tobyrobb/Ardev-Version-2/ARDEV2_top.jpg

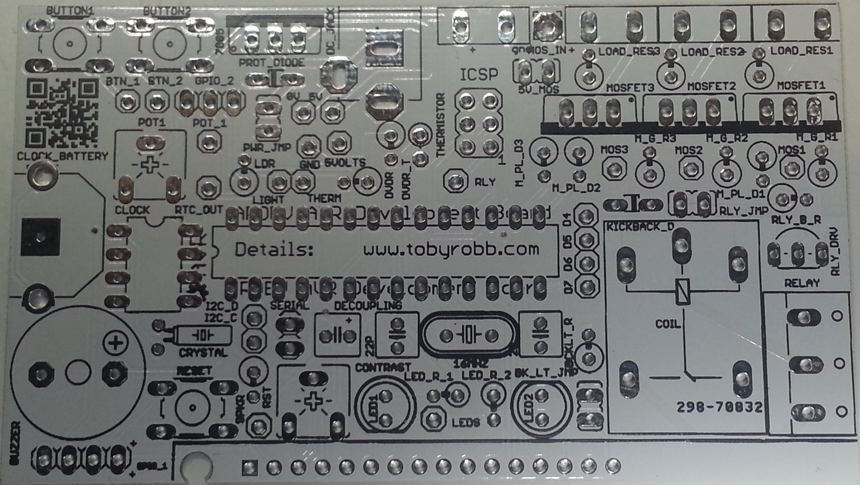
ARDEV2_top.jpg
