tobyrobb/Ardev-Version-2/PCB_LAYOUT.jpg

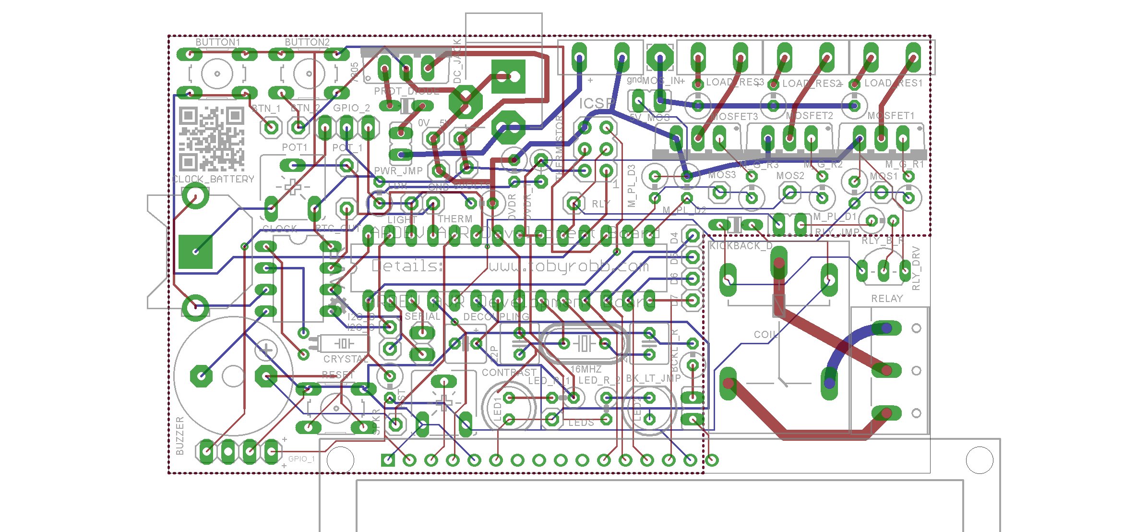
PCB_LAYOUT.jpg
