tobyrobb/Ardev-Version-2/README.md

Ardev-Version-2
===============

A code repository for the ARDEV version 2 Arduino IDE based development board

Try here for information about the board.

http://tobyrobb.com/wordpress/?p=747
