tobyrobb/Ardev-Version-2/ARDEV2_bottom.jpg

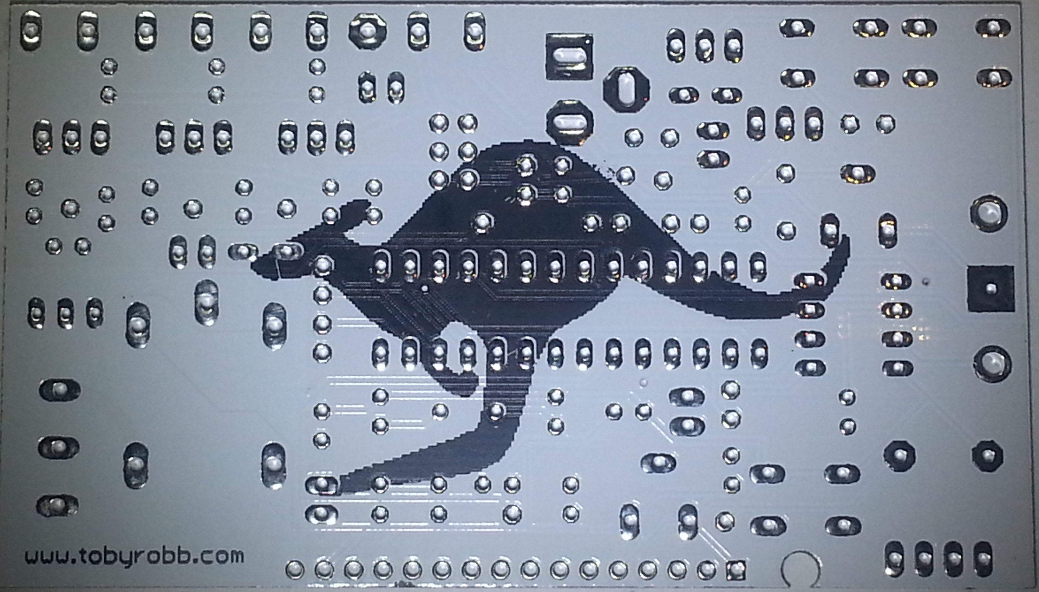
ARDEV2_bottom.jpg
