tobyrobb/Ardev-Version-2/ARDEV2_SCHEMATIC.jpg

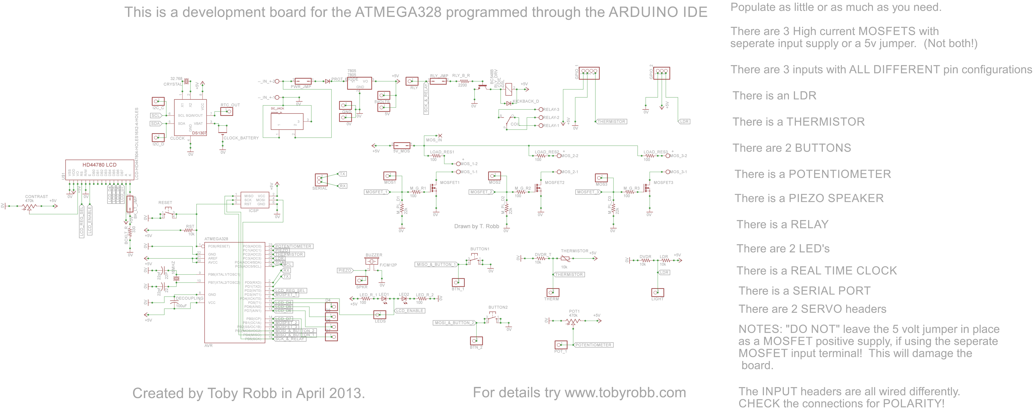
ARDEV2_SCHEMATIC.jpg
