tobyrobb/Ardev-Version-2/Populated.jpg

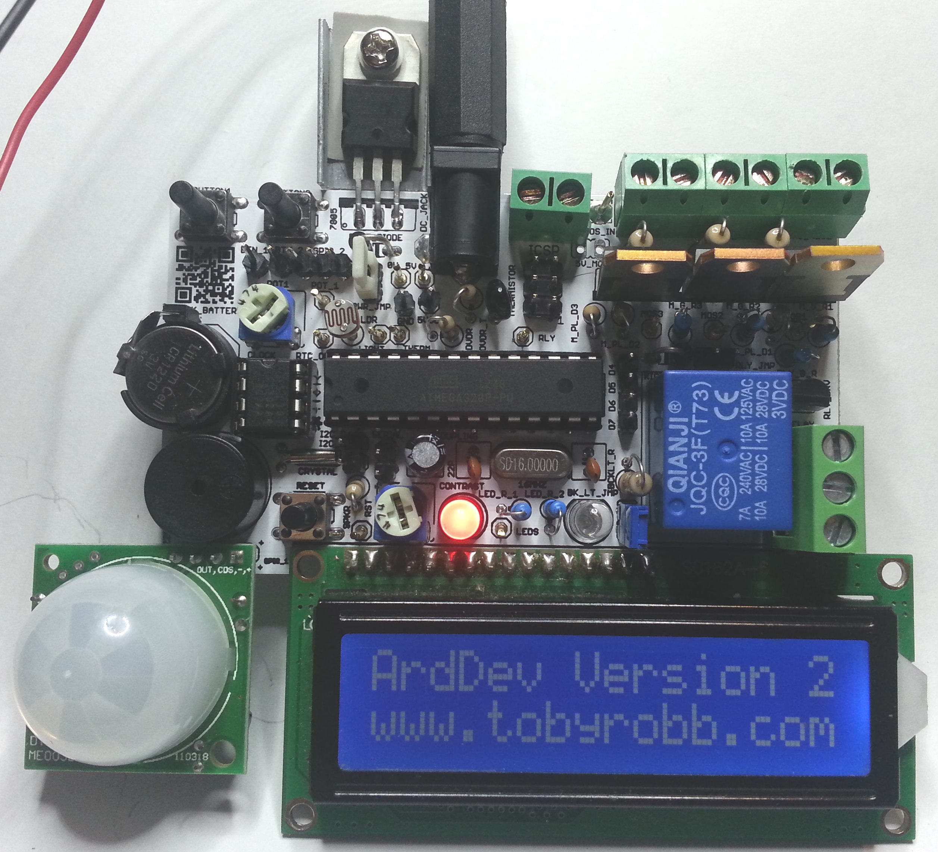
Populated.jpg
