tobyrobb/Ardev-Version-2/Populated_close_up.jpg

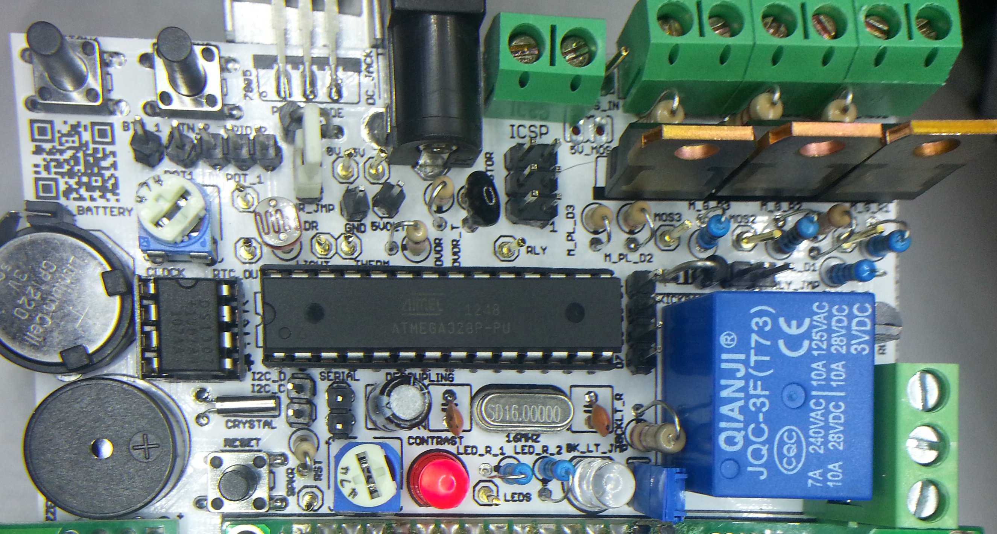
Populated_close_up.jpg
