tobyrobb/Ardev-Version-2/Ardev version 3.brd

## EAGLE design Ardev version 3.brd (2014-05-05)

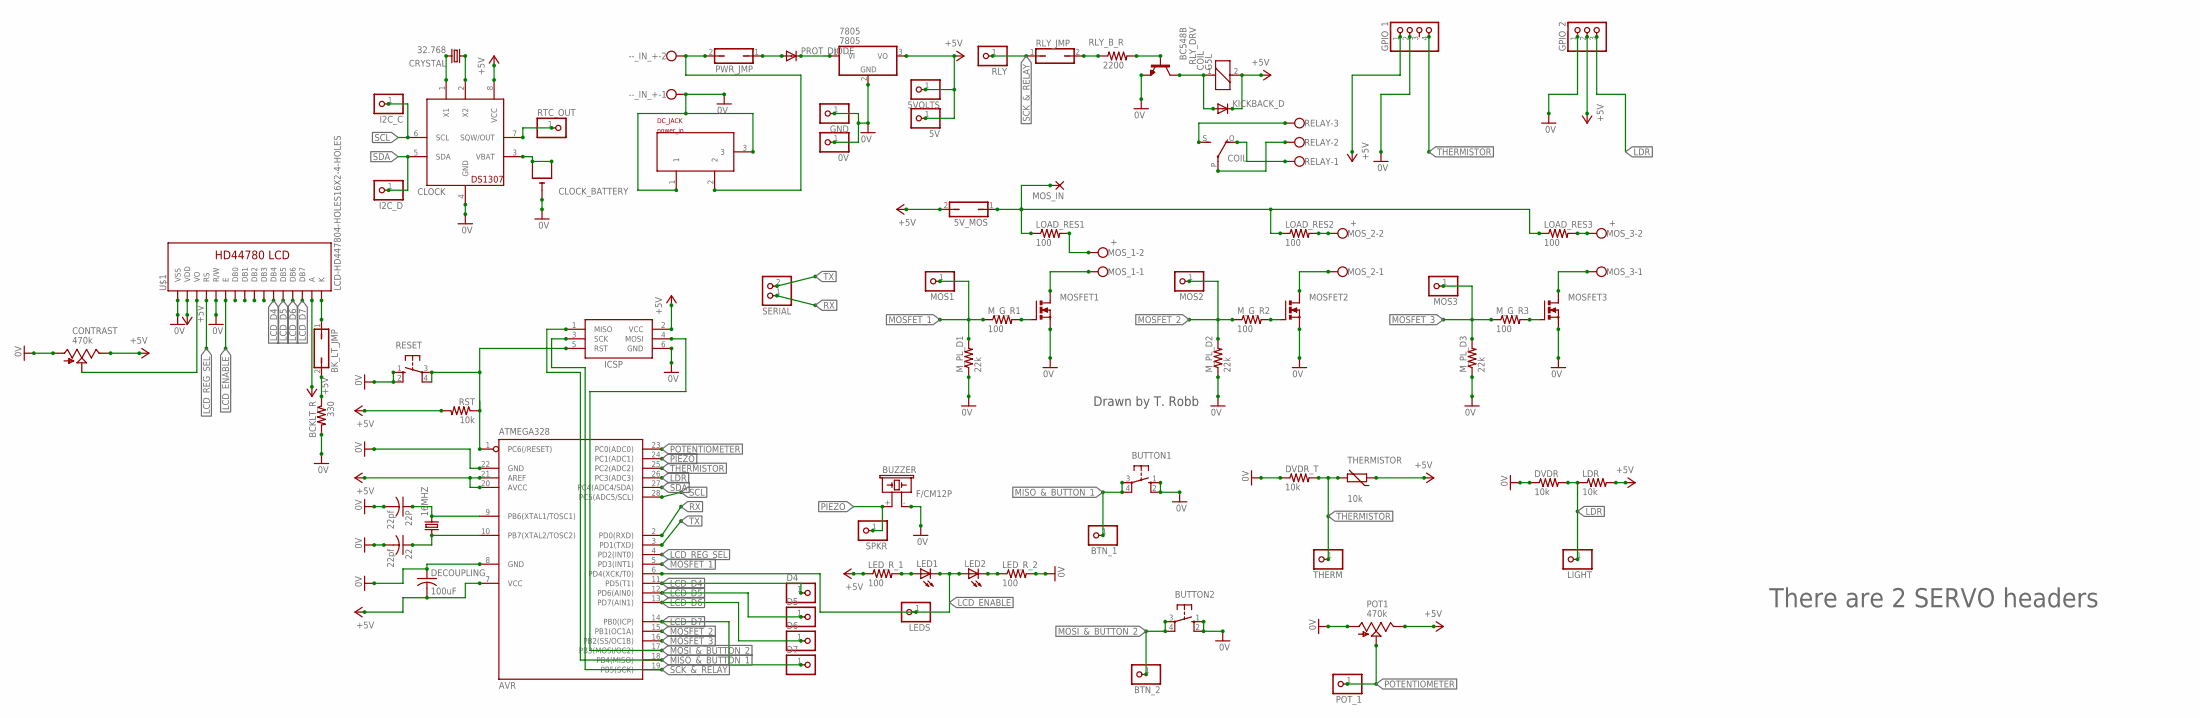
[picture p7: schematic Ardev version 3.sch]

Parts:
0V, 5V, 5VOLTS: PINHD-1X1; 1X01
5V_MOS: JP1Q; JP1
16MHZ: CRYSTALHC49U-V; HC49U-V
22, 22P: 22pf; C025-050X050
7805: 7805; TO220V
--_IN_+: W237-102
AVR: ATMEGA328; DIL28-3
BCKLT_R: 330; 0309V
BK_LT_JMP: JP1Q; JP1
BTN_1, BTN_2: PINHD-1X1; 1X01
BUTTON1, BUTTON2: 10-XX; B3F-10XX
BUZZER: F/CM12P
CLOCK: DS1307; DIL08
CLOCK_BATTERY: CR1220THM; CR1220-THM
COIL: G5L; G5LE
CONTRAST: 470k; CA6V
CRYSTAL: 32.768; TC26H
D4, D5, D6, D7: PINHD-1X1; 1X01
DC_JACK: power_in; SMARTPRJ_POWERSUPPLY_DC-21MM
DECOUPLING: 100uF; C025-050X050
DVDR: 10k; 0309V
DVDR_T: 10k; 0309V
GND: PINHD-1X1; 1X01
GPIO_1: PINHD-1X4; 1X04
GPIO_2: PINHD-1X3; 1X03
I2C_C, I2C_D: PINHD-1X1; 1X01
ICSP: AVRISP-6; AVRISP
KICKBACK_D: DIODE-D-7.5; D-7.5
LDR: 10k; 0309V
LED1, LED2: LED5MM
LEDS: PINHD-1X1; 1X01
LED_R_1, LED_R_2: 100; 0207/2V
LIGHT: PINHD-1X1; 1X01
LOAD_RES1, LOAD_RES2, LOAD_RES3: 100; 0309V
MOS1, MOS2, MOS3: PINHD-1X1; 1X01
MOSFET1, MOSFET2, MOSFET3: IRF512; TO220BV
MOS_1, MOS_2, MOS_3: +; W237-102
MOS_IN: 3,17/1,3
M_G_R1, M_G_R2, M_G_R3: 100; 0309V
M_PL_D1, M_PL_D2, M_PL_D3: 22k; 0309V
POT1: 470k; CA6V
POT_1: PINHD-1X1; 1X01
PROT_DIODE: DIODE-D-7.5; D-7.5
PWR_JMP: JP1Q; JP1
RELAY: W237-103
RESET: 10-XX; B3F-10XX
RLY: PINHD-1X1; 1X01
RLY_B_R: 2200; 0309V
RLY_DRV: BC548B; TO92-EBC
RLY_JMP: JP1Q; JP1
RST: 10k; 0309V
RTC_OUT: PINHD-1X1; 1X01
SERIAL: PINHD-1X2; 1X02
SPKR: PINHD-1X1; 1X01
THERM: PINHD-1X1; 1X01
THERMISTOR: 10k; RS-2,5
U$1: LCD-HD447804-HOLES16X2-4-HOLES; LCD-16X2-4HOLES

Connections:
0V: 0V.1, 22.2, 22P.2, 7805.2 (GND), --_IN_+.1, AVR.8 (GND), AVR.22 (GND), BCKLT_R.2, BUTTON1.1 (S), BUTTON1.2 (S1), BUTTON2.1 (S), BUTTON2.2 (S1), BUZZER.- (2), CLOCK.4 (GND), CLOCK_BATTERY.-, CONTRAST.A, DC_JACK.1, DC_JACK.3, DECOUPLING.1, DVDR.1, DVDR_T.1, GND.1, GPIO_1.2, GPIO_2.1, ICSP.6 (GND), LED_R_2.2, MOSFET1.S, MOSFET2.S, MOSFET3.S, M_PL_D1.1, M_PL_D2.1, M_PL_D3.1, POT1.A, RESET.1 (S), RESET.2 (S1), RLY_DRV.E, U$1.1 (VSS), U$1.5 (R/W)
+5V: 5V.1, 5VOLTS.1, 5V_MOS.2, 7805.3 (VO), AVR.7 (VCC), AVR.20 (AVCC), AVR.21 (AREF), CLOCK.8 (VCC), COIL.2, CONTRAST.E, DECOUPLING.2, GPIO_1.1, GPIO_2.2, ICSP.2 (VCC), KICKBACK_D.C, LDR.2, LED_R_1.1, POT1.E, RST.2, THERMISTOR.1, U$1.2 (VDD), U$1.15 (A)
LCD_D4: AVR.11 (PD5(T1)), D4.1, U$1.11 (DB4)
LCD_D5: AVR.12 (PD6(AIN0)), D5.1, U$1.12 (DB5)
LCD_D6: AVR.13 (PD7(AIN1)), D6.1, U$1.13 (DB6)
LCD_D7: AVR.14 (PB0(ICP)), D7.1, U$1.14 (DB7)
LCD_ENABLE: AVR.6 (PD4(XCK/T0)), LED1.K (C), LED2.A, LEDS.1, U$1.6 (E)
LCD_REG_SEL: AVR.4 (PD2(INT0)), U$1.4 (RS)
LDR: AVR.26 (PC3(ADC3)), DVDR.2, GPIO_2.3, LDR.1, LIGHT.1
MISO_&_BUTTON_1: AVR.18 (PB4(MISO)), BTN_1.1, BUTTON1.3, BUTTON1.4 (P1), ICSP.1 (MISO)
MOSFET_1: AVR.5 (PD3(INT1)), MOS1.1, M_G_R1.1, M_PL_D1.2
MOSFET_2: AVR.15 (PB1(OC1A)), MOS2.1, M_G_R2.1, M_PL_D2.2
MOSFET_3: AVR.16 (PB2(SS/OC1B)), MOS3.1, M_G_R3.1, M_PL_D3.2
MOSI_&_BUTTON_2: AVR.17 (PB3(MOSI/OC2)), BTN_2.1, BUTTON2.3, BUTTON2.4 (P1), ICSP.4 (MOSI)
unnamed: --_IN_+.2, DC_JACK.2, PWR_JMP.2
unnamed: PROT_DIODE.A, PWR_JMP.1
unnamed: AVR.1 (PC6(/RESET)), ICSP.5 (RST), RESET.3, RESET.4 (P1), RST.1
unnamed: 7805.1 (VI), PROT_DIODE.C
unnamed: LOAD_RES1.2, MOS_1.2
unnamed: MOSFET1.D, MOS_1.1
unnamed: 16MHZ.2, 22P.1, AVR.9 (PB6(XTAL1/TOSC1))
unnamed: LOAD_RES3.2, MOS_3.2
unnamed: MOSFET3.D, MOS_3.1
unnamed: 16MHZ.1, 22.1, AVR.10 (PB7(XTAL2/TOSC2))
unnamed: LOAD_RES2.2, MOS_2.2
unnamed: MOSFET2.D, MOS_2.1
unnamed: CLOCK.2 (X2), CRYSTAL.1
unnamed: CLOCK.1 (X1), CRYSTAL.2
unnamed: CLOCK.3 (VBAT), CLOCK_BATTERY.+1 (+), CLOCK_BATTERY.+2 (+1)
unnamed: LED1.A, LED_R_1.2
unnamed: COIL.O, RELAY.1
unnamed: COIL.P, RELAY.2
unnamed: COIL.S, RELAY.3
unnamed: 5V_MOS.1, LOAD_RES1.1, LOAD_RES2.1, LOAD_RES3.1, MOS_IN.1
unnamed: LED2.K (C), LED_R_2.1
unnamed: CLOCK.7 (SQW/OUT), RTC_OUT.1
unnamed: COIL.1, KICKBACK_D.A, RLY_DRV.C
unnamed: MOSFET3.G, M_G_R3.2
unnamed: CONTRAST.S, U$1.3 (VO)
unnamed: MOSFET2.G, M_G_R2.2
unnamed: MOSFET1.G, M_G_R1.2
unnamed: BK_LT_JMP.1, U$1.16 (K)
unnamed: BCKLT_R.1, BK_LT_JMP.2
unnamed: RLY_B_R.2, RLY_DRV.B
unnamed: RLY_B_R.1, RLY_JMP.2
PIEZO: AVR.24 (PC1(ADC1)), BUZZER.+ (1), SPKR.1
POTENTIOMETER: AVR.23 (PC0(ADC0)), POT1.S, POT_1.1
RX: AVR.2 (PD0(RXD)), SERIAL.1
SCK_&_RELAY: AVR.19 (PB5(SCK)), ICSP.3 (SCK), RLY.1, RLY_JMP.1
SCL: AVR.28 (PC5(ADC5/SCL)), CLOCK.6 (SCL), I2C_C.1
SDA: AVR.27 (PC4(ADC4/SDA)), CLOCK.5 (SDA), I2C_D.1
THERMISTOR: AVR.25 (PC2(ADC2)), DVDR_T.2, GPIO_1.4, THERM.1, THERMISTOR.2
TX: AVR.3 (PD1(TXD)), SERIAL.2

Notes on the sheet:
Drawn by T. Robb
There are 2 SERVO headers

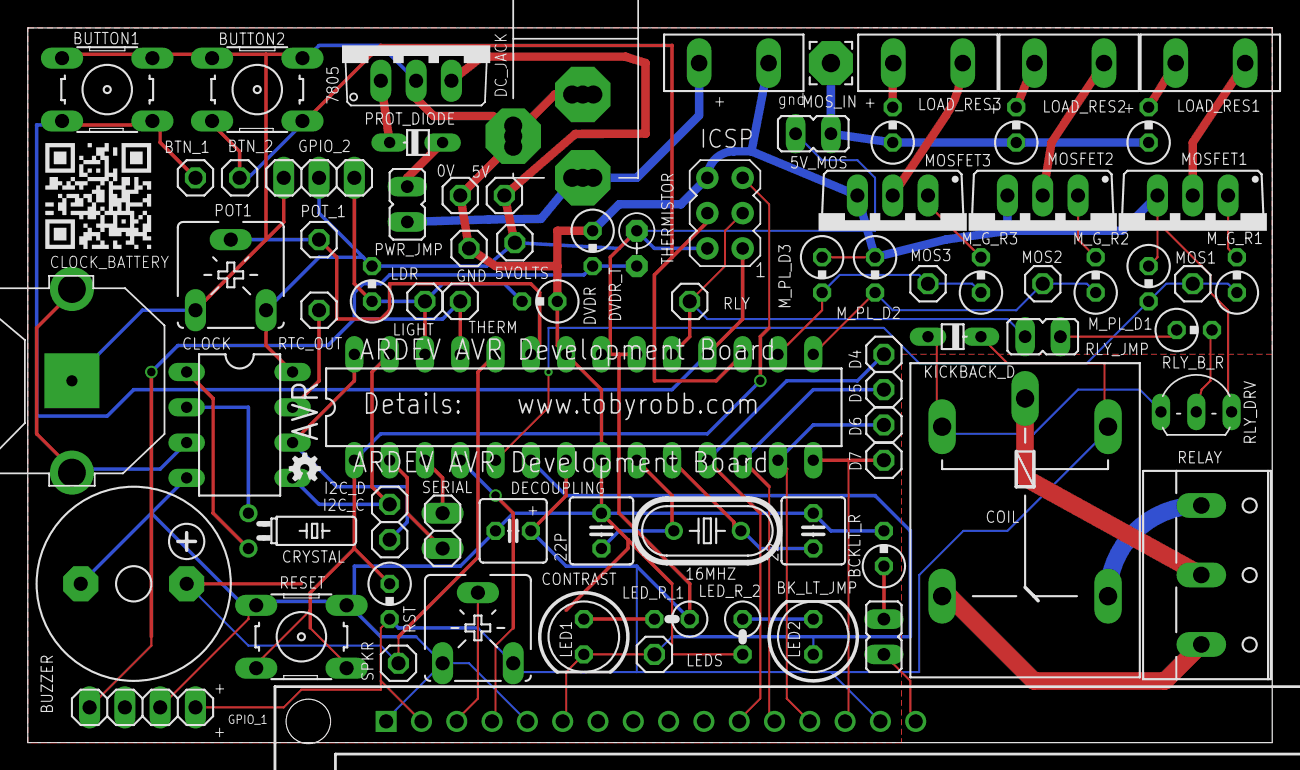
[picture p8: board Ardev version 3.brd from above]

Board: 2 copper layers, 89.5 x 51.4 mm, 80 parts (0 on the bottom side), 53 nets.
