tobyrobb/Ardev-Version-2/(commit log)

2014-05-04 Arduino development board ARDEV version 2
    A code repository for the ARDEV version 2 Arduino IDE based development
    board
2014-05-04 ARDEV2 Arduino development board examples
    ARDEV2 Arduino development board examples
2014-05-05 Arduino Development Board Version 2
    Arduino Development Board Version 2
    [Ardev version 3.brd, Ardev version 3.sch]
2014-08-06 Create LEDWidget_wiggo_V3
